c-not-around/rfrw/docs/EM-marine format.png

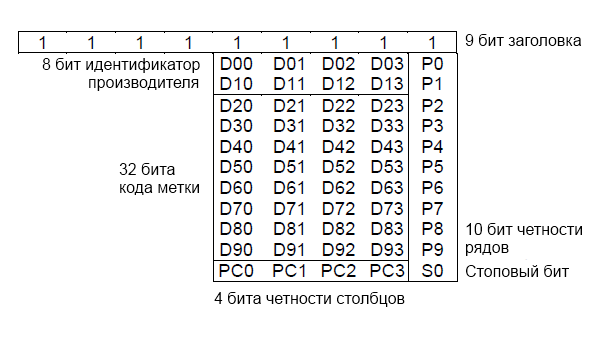
docs/EM-marine format.png
