c-not-around/rfrw/hardware/ATmega328/pcb/module_pcb_dip.png

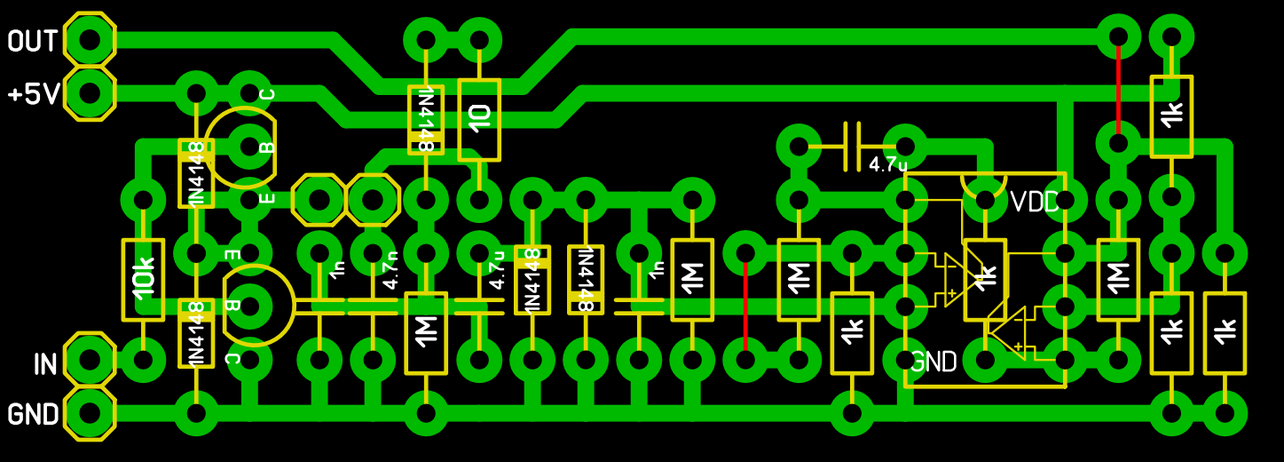
hardware/ATmega328/pcb/module_pcb_dip.png
