c-not-around/rfrw/hardware/ATmega328/pcb/module_pcb_smd.png

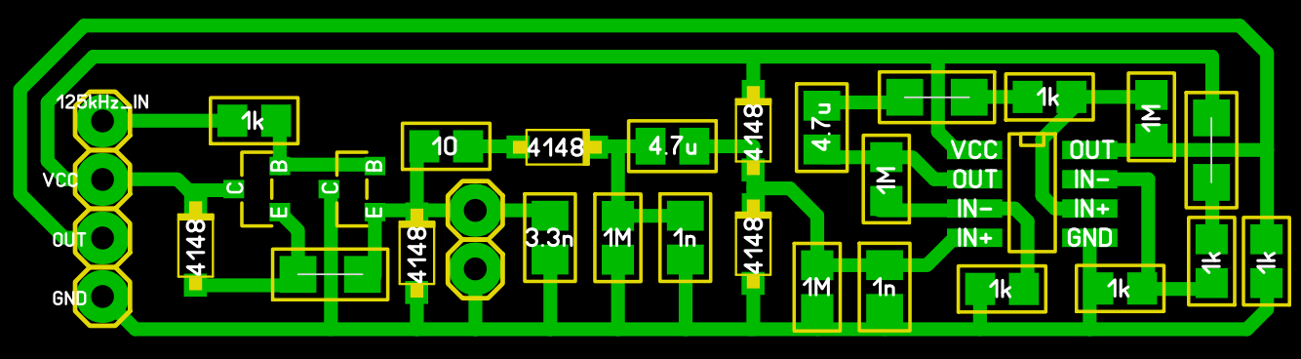
hardware/ATmega328/pcb/module_pcb_smd.png
