c-not-around/rfrw/hardware/ATmega328/schematics/arduino_schematics.png

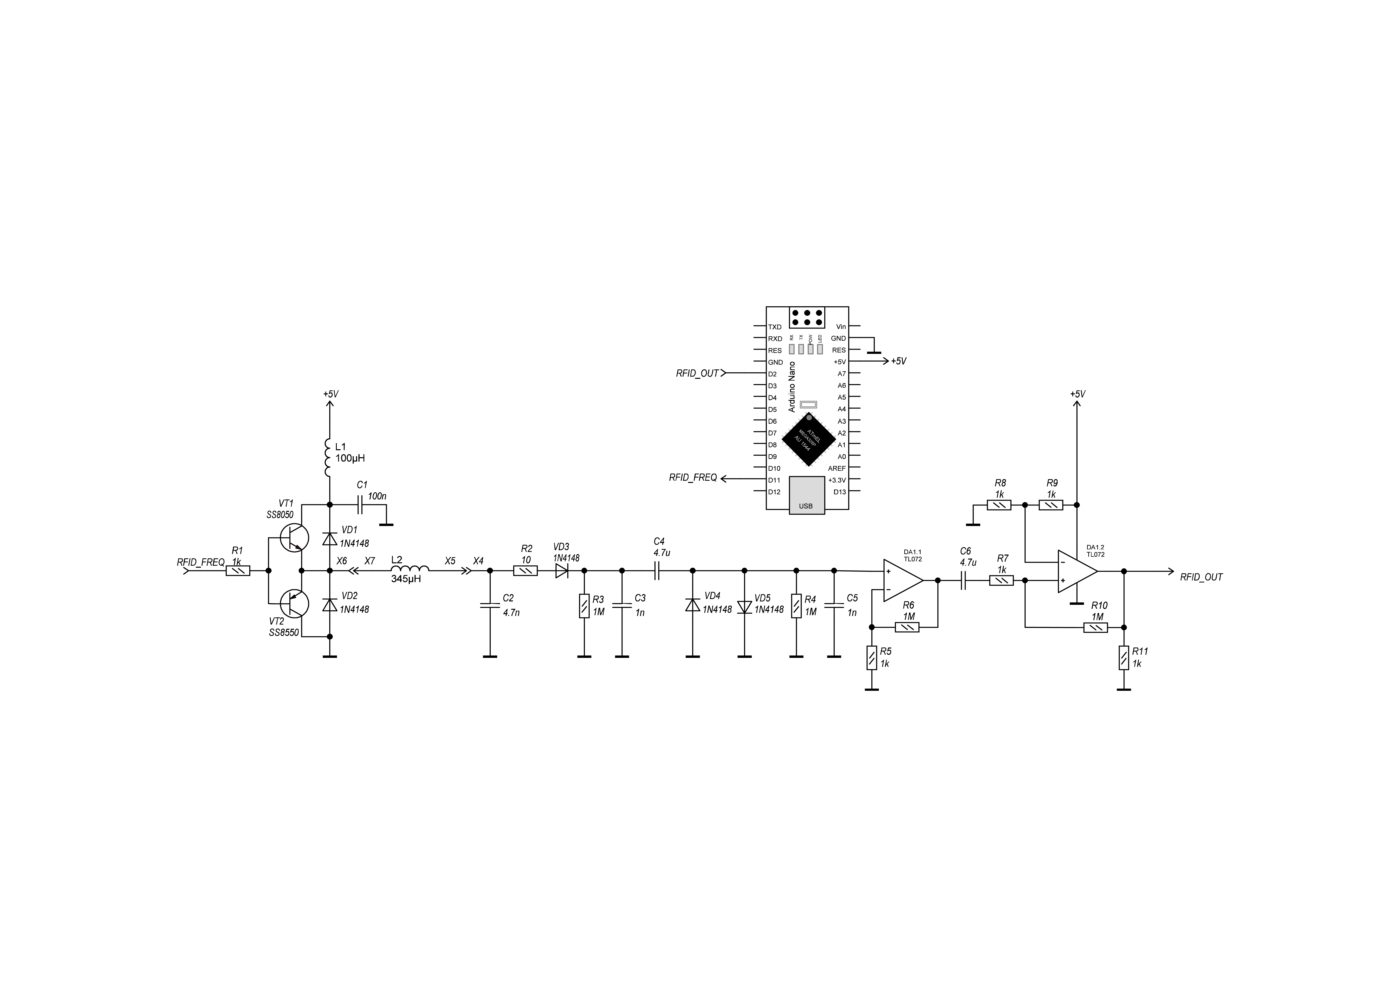
hardware/ATmega328/schematics/arduino_schematics.png
