c-not-around/rfrw/hardware/ATmega328/schematics/atmega328_schematics.png

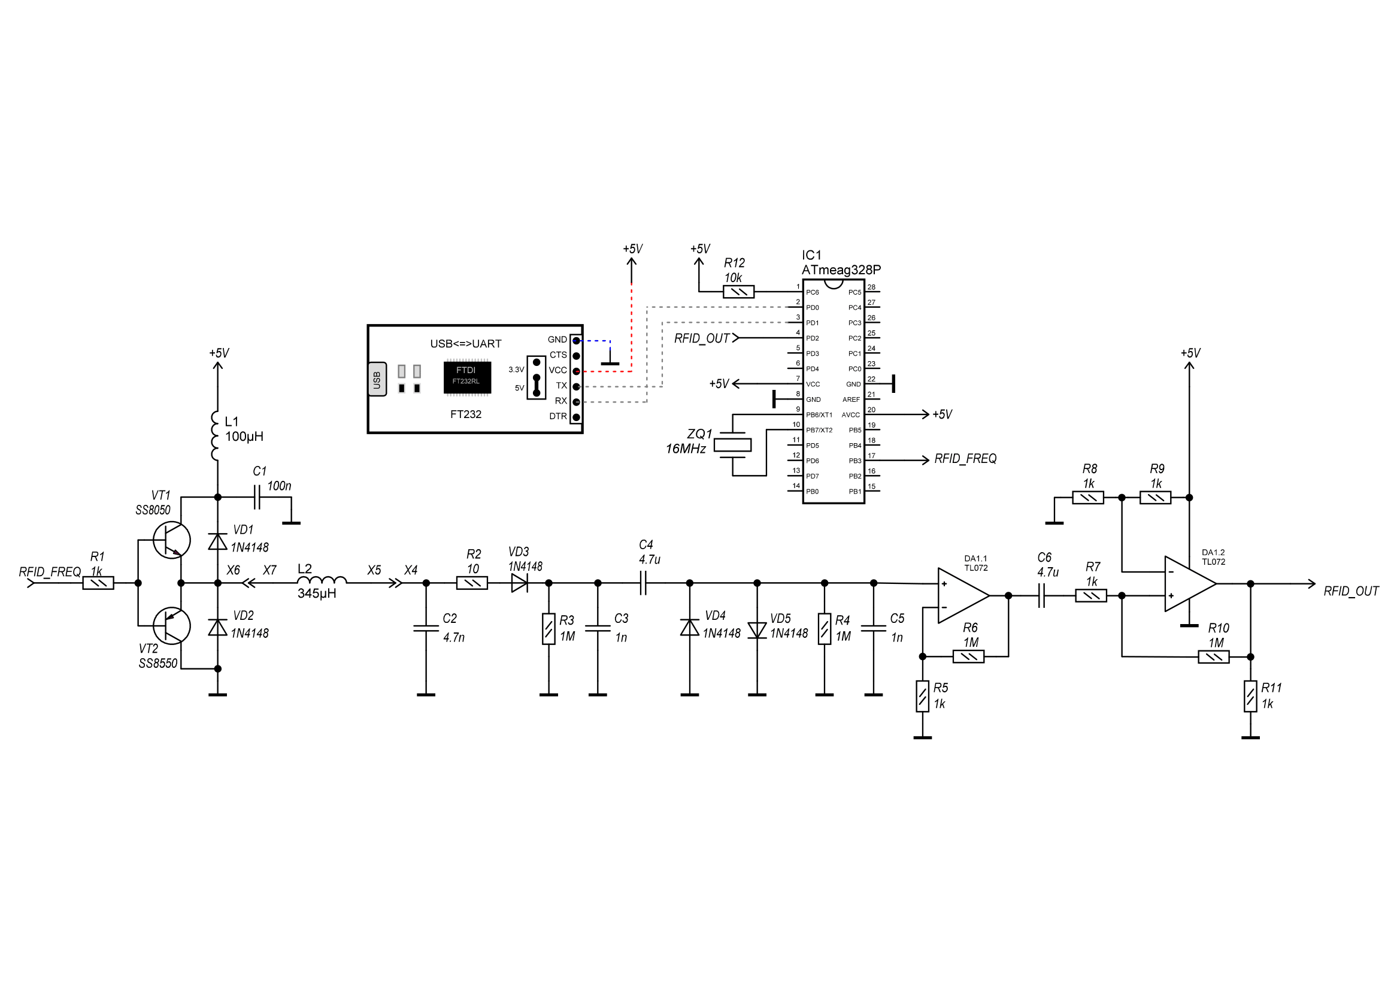
hardware/ATmega328/schematics/atmega328_schematics.png
