c-not-around/rfrw/hardware/PIC12F1840/pcb/default_pcb.png

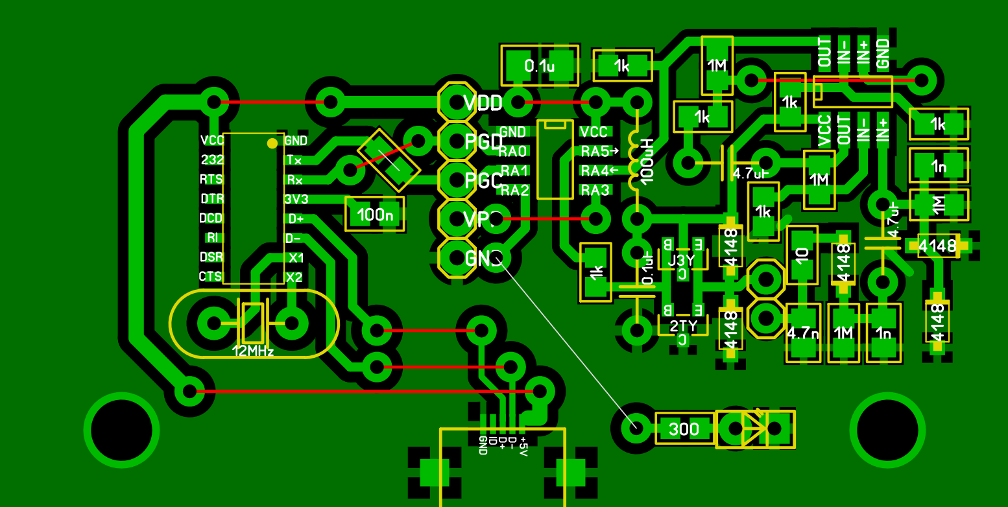
hardware/PIC12F1840/pcb/default_pcb.png
