c-not-around/rfrw/hardware/PIC12F1840/pcb/module_pcb.png

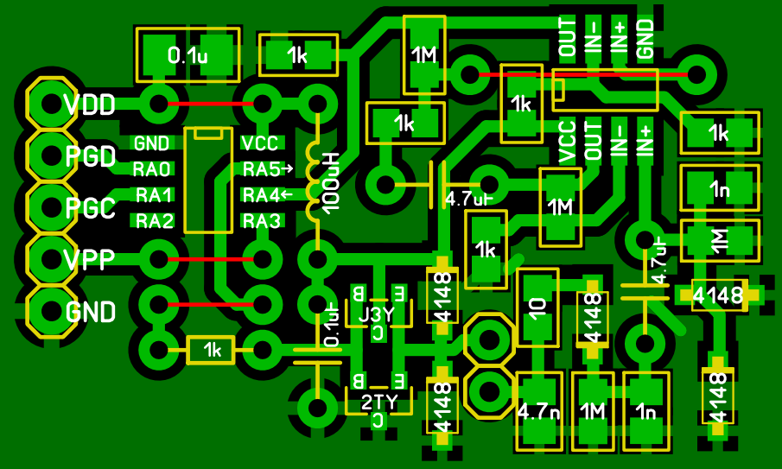
hardware/PIC12F1840/pcb/module_pcb.png
