c-not-around/rfrw/hardware/PIC12F1840/schematics/default_schematics.png

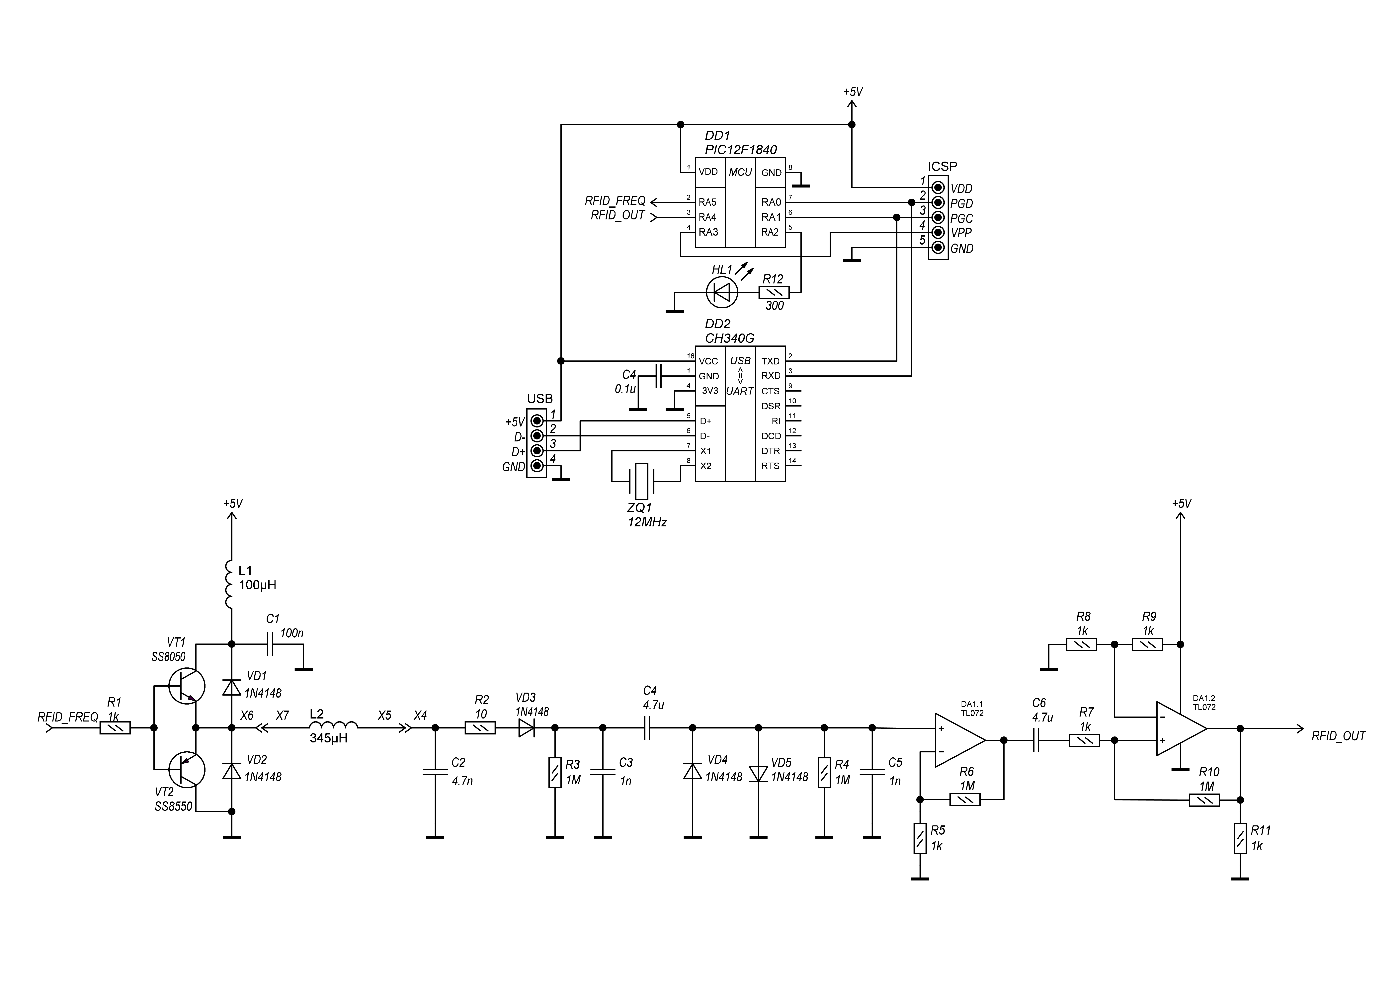
hardware/PIC12F1840/schematics/default_schematics.png
