c-not-around/rfrw/hardware/PIC12F1840/schematics/rdm6300_schematics_initial.jpg

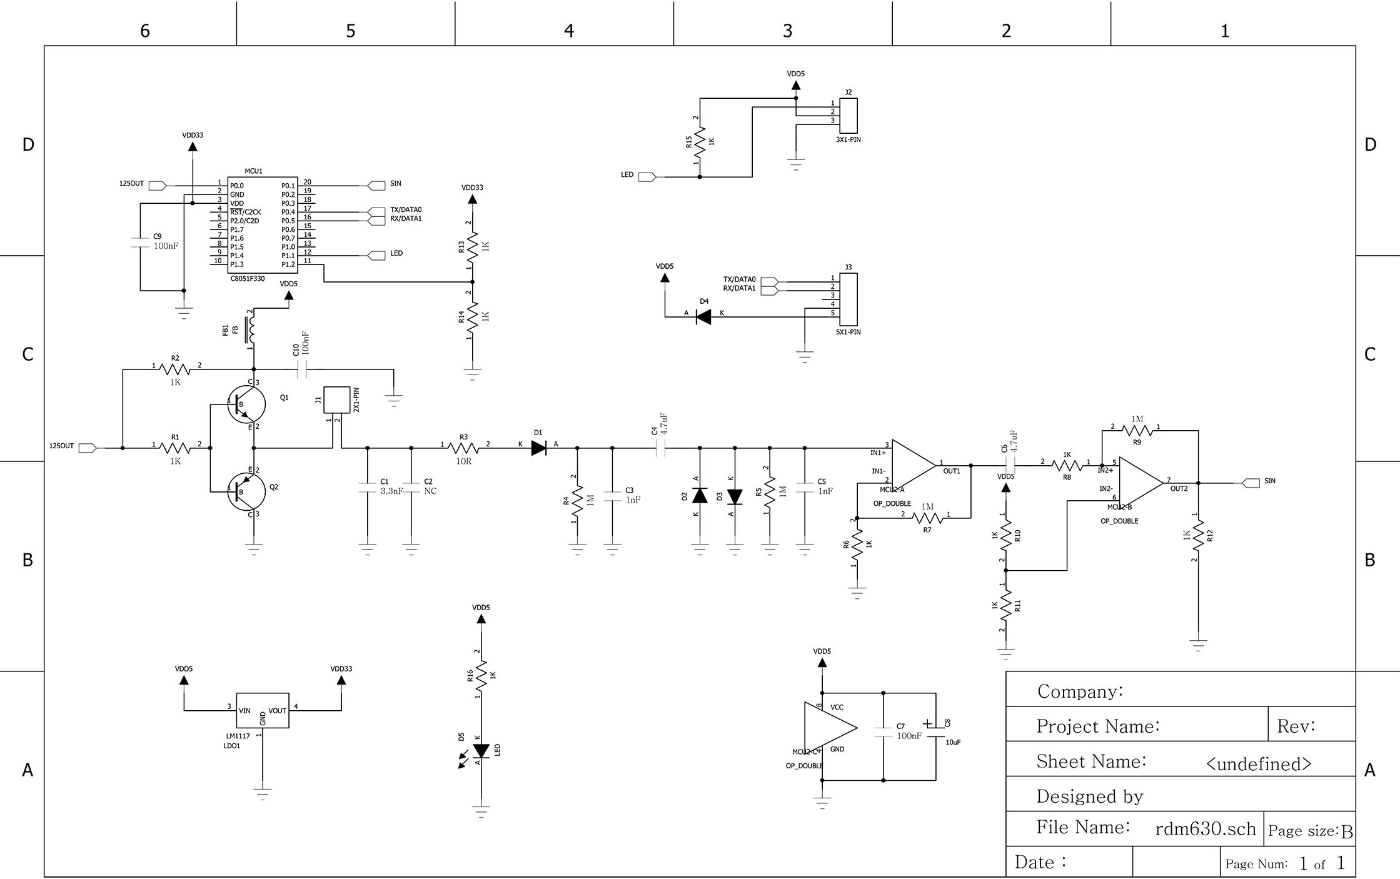
hardware/PIC12F1840/schematics/rdm6300_schematics_initial.jpg
