c-not-around/rfrw/hardware/ATmega328/schematics/arduino_schematics.pdf

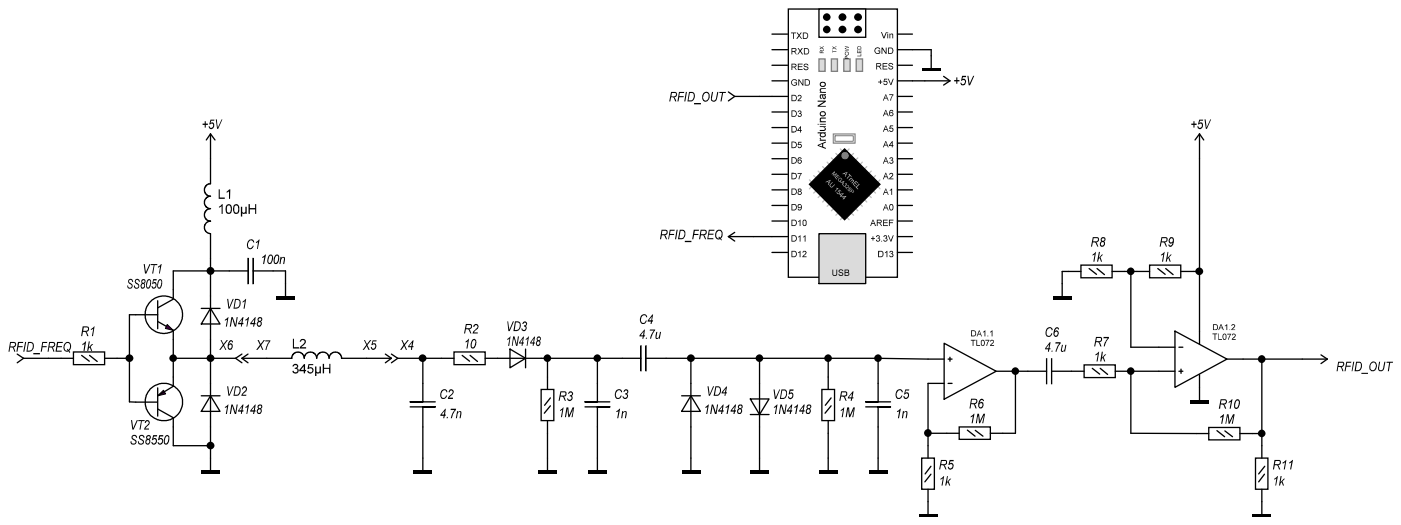
[picture p11: page 1]
