c-not-around/rfrw/hardware/ATmega328/schematics/atmega328_schematics.pdf

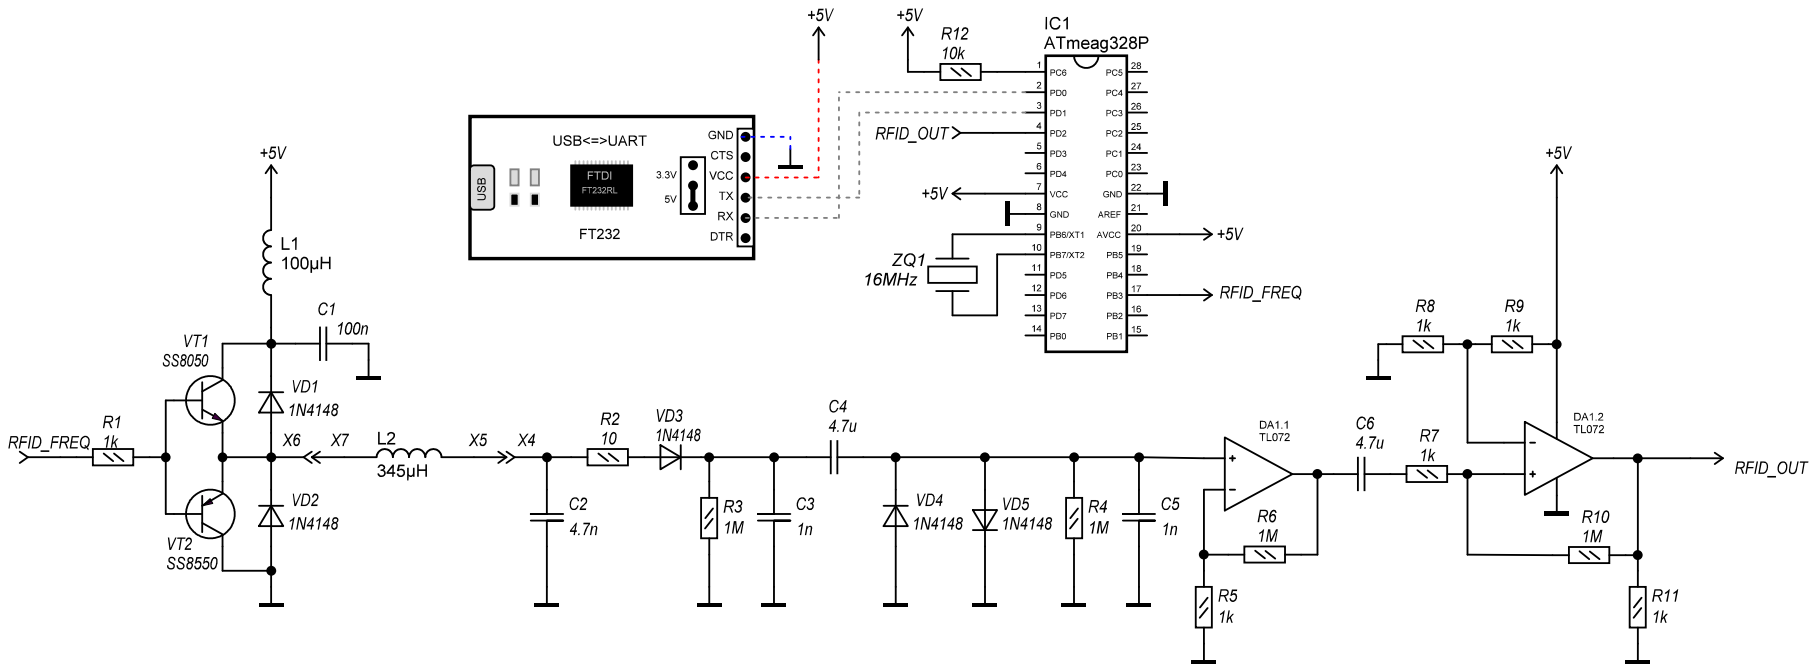
[picture p12: page 1]
