c-not-around/rfrw/hardware/PIC12F1840/schematics/default_schematics.pdf

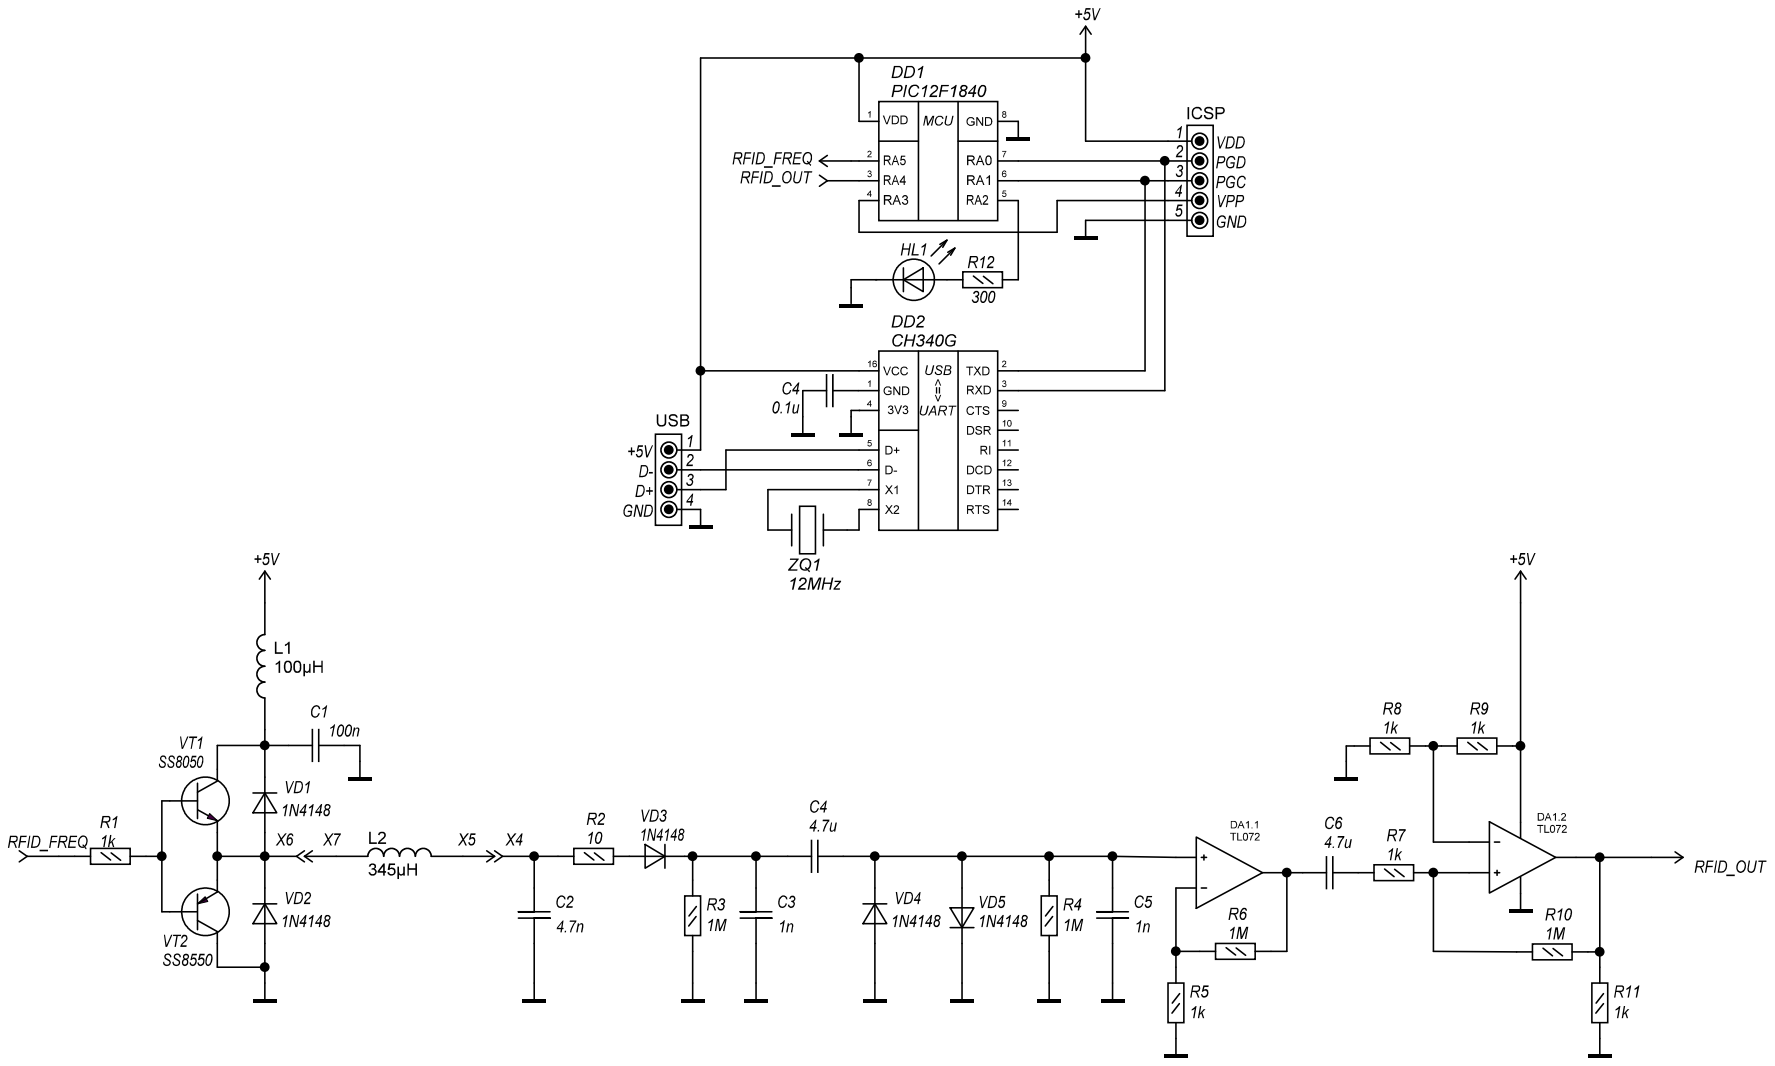
[picture p13: page 1]
