c-not-around/rfrw/hardware/PIC12F1840/schematics/module_schematics.pdf

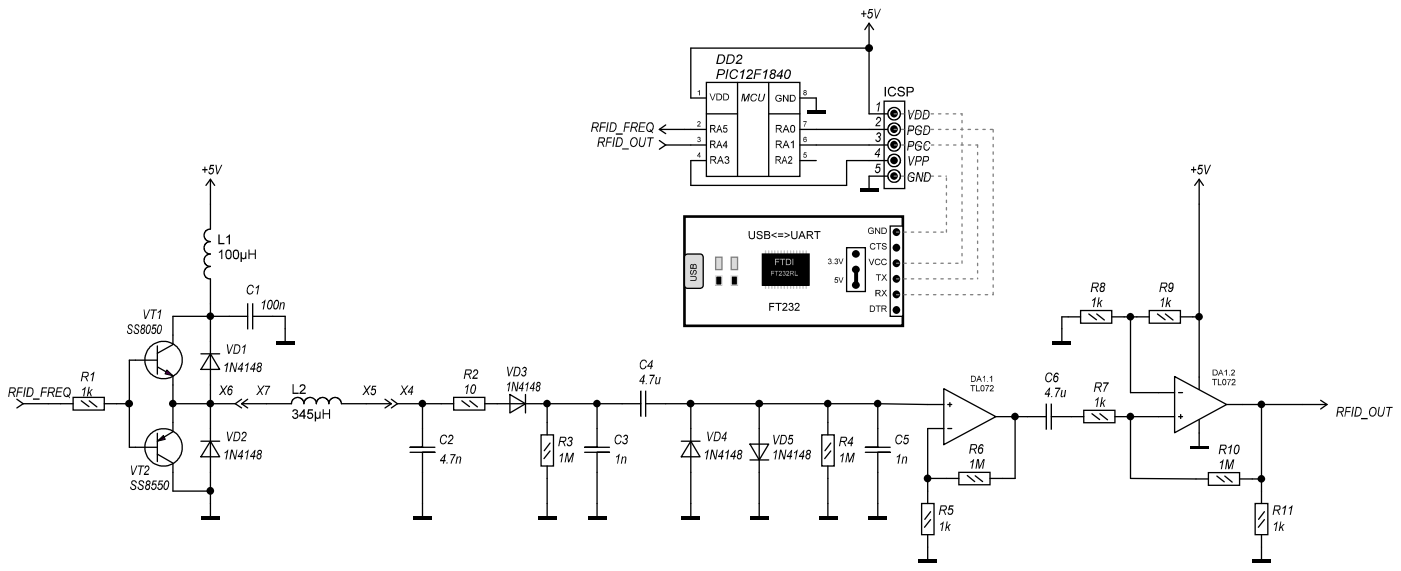
[picture p14: page 1]
