c-not-around/rfrw/hardware/PIC12F1840/schematics/rdm6300_schematics.pdf

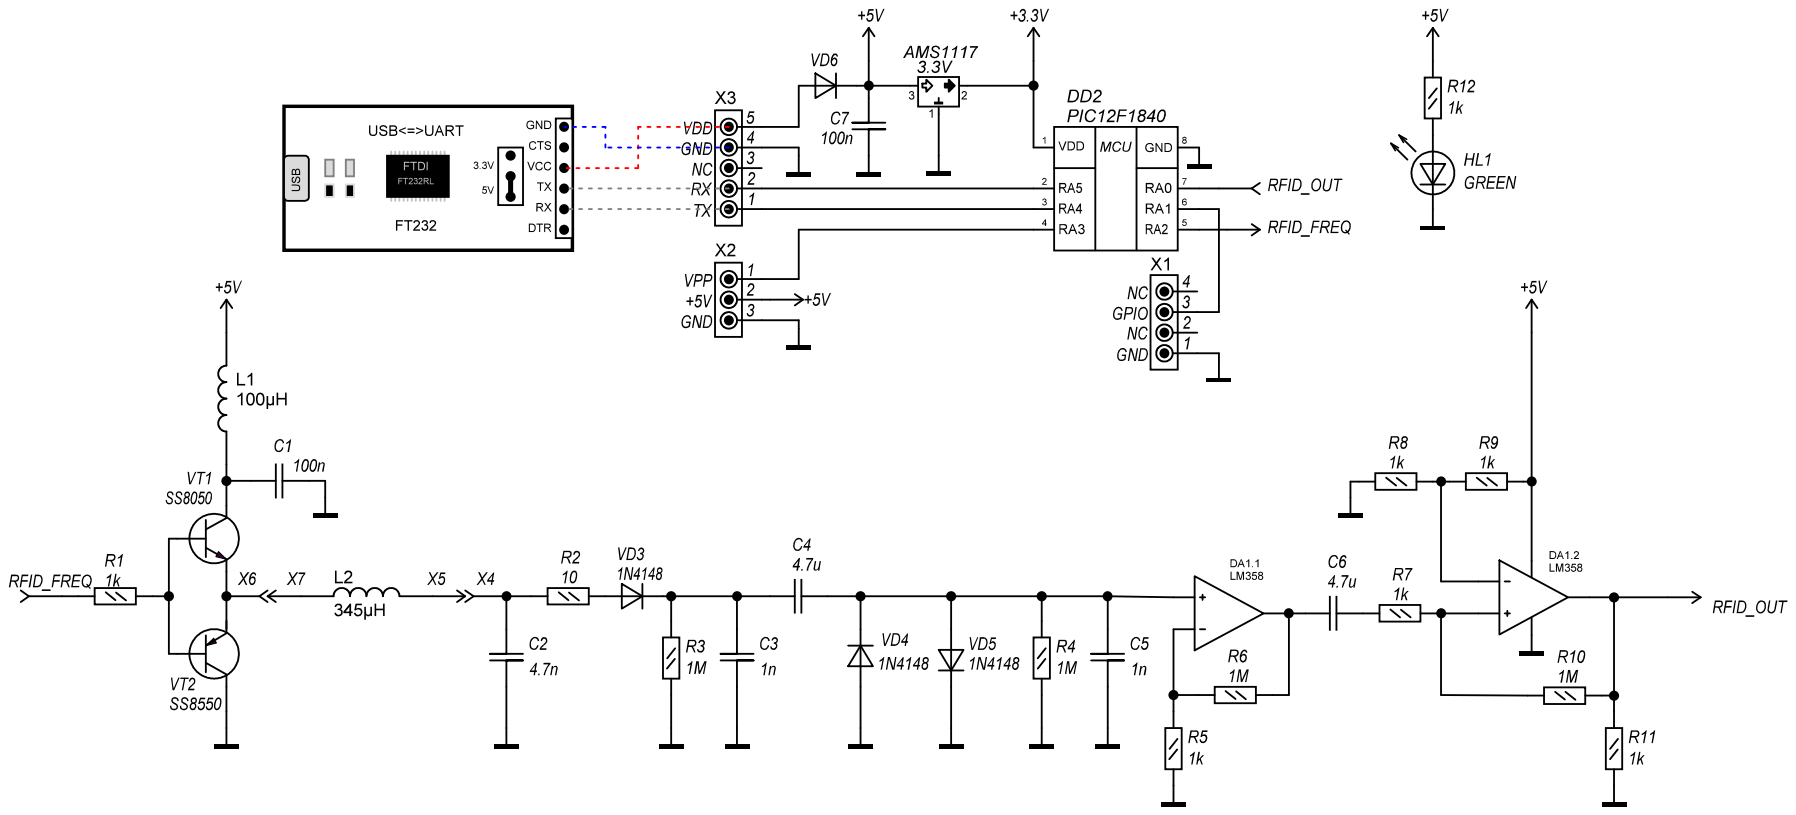
[picture p15: page 1]
