c-not-around/rfrw/(list of files, drawings)

Other design files:
hardware/ATmega328/model_328.pdsprj
hardware/ATmega328/pcb/module_pcb_dip.lay6
hardware/ATmega328/pcb/module_pcb_smd.lay6
hardware/ATmega328/schematics/arduino_schematics.spl8
hardware/ATmega328/schematics/atmega328_schematics.spl8
hardware/PIC12F1840/model_1840.pdsprj
hardware/PIC12F1840/pcb/default_pcb.lay6
hardware/PIC12F1840/pcb/module_pcb.lay6
hardware/PIC12F1840/schematics/default_schematics.spl8
hardware/PIC12F1840/schematics/module_schematics.spl8
hardware/PIC12F1840/schematics/rdm6300_schematics.spl8
