c-not-around/rfrw/hardware/ATmega328/firmware/rfid/rfid_em4x05.h

#ifndef _RFID_EM4X05_H
#define _RFID_EM4X05_H


#include "rfid_defs.h"


//	EM4205, EM4305

#define EM4X05_GAP_LOW1_US			(6*RFID_TC_US)
#define EM4X05_GAP_HIGH1_US			(12*RFID_TC_US)
#define EM4X05_GAP_LOW2_US			(40*RFID_TC_US)
#define EM4X05_GAP_HIGH2_US			(17*RFID_TC_US)

#define EM4X05_BIT_ZERO_LOW_US		(15*RFID_TC_US)
#define EM4X05_BIT_ZERO_HIGH_US		(17*RFID_TC_US)
#define EM4X05_BIT_ONE_HIGH_US		(32*RFID_TC_US)

#define EM4X05_CRC_DISABLE			0x00
#define EM4X05_CRC_ENABLE			0x80

#define EM4X05_COMMAND_BITS			3
#define EM4X05_ADDRESS_BITS			6

#define EM4X05_COMMAND_LOGIN		0x4
#define EM4X05_COMMAND_WRITE_WORD	0x2
#define EM4X05_COMMAND_READ_WORD	0x1
#define EM4X05_COMMAND_PROTECT		0x3
#define EM4X05_COMMAND_DISABLE		0x5

#define EM4X05_BLOCK_ADR_CONFIG		0x4
#define EM4X05_BLOCK_ADR_KEY_L		0x5
#define EM4X05_BLOCK_ADR_KEY_H		0x6

#define EM4X05_BLOCK_BYTES			4
#define EM4X05_BLOCK_WRITE_MS		100
#define EM4X05_WRITE_MS				500

#define EM4X05_CFG_BITRATE_RF8		0x00000003UL
#define EM4X05_CFG_BITRATE_RF16		0x00000007UL
#define EM4X05_CFG_BITRATE_RF32		0x0000000FUL
#define EM4X05_CFG_BITRATE_RF40		0x00000013UL
#define EM4X05_CFG_BITRATE_RF64		0x0000001FUL

#define EM4X05_CFG_CODE_MANCHSTER	0x00000040UL
#define EM4X05_CFG_CODE_BIPHASE		0x00000080UL

#define EM4X05_CFG_DELAY_NO			0x00000000UL
#define EM4X05_CFG_DELAY_BP4		0x00001000UL
#define EM4X05_CFG_DELAY_BP8		0x00002000UL

#define EM4X05_CFG_LAST_WORD_0		0x00000000UL
#define EM4X05_CFG_LAST_WORD_1		0x00004000UL
#define EM4X05_CFG_LAST_WORD_2		0x00008000UL
#define EM4X05_CFG_LAST_WORD_3		0x0000C000UL
#define EM4X05_CFG_LAST_WORD_4		0x00010000UL
#define EM4X05_CFG_LAST_WORD_5		0x00014000UL
#define EM4X05_CFG_LAST_WORD_6		0x00018000UL
#define EM4X05_CFG_LAST_WORD_7		0x0001C000UL
#define EM4X05_CFG_LAST_WORD_8		0x00020000UL
#define EM4X05_CFG_LAST_WORD_9		0x00024000UL
#define EM4X05_CFG_LAST_WORD_10		0x00028000UL
#define EM4X05_CFG_LAST_WORD_11		0x0002C000UL
#define EM4X05_CFG_LAST_WORD_12		0x00030000UL
#define EM4X05_CFG_LAST_WORD_13		0x00034000UL
#define EM4X05_CFG_LAST_WORD_14		0x00038000UL
#define EM4X05_CFG_LAST_WORD_15		0x0003C000UL

#define EM4X05_CFG_LOGIN_DISABLE	0x00000000UL
#define EM4X05_CFG_LOGIN_READ		0x00040000UL
#define EM4X05_CFG_LOGIN_WRITE		0x00100000UL
#define EM4X05_CFG_LOGIN_READWRITE	0x00140000UL

#define EM4X05_CFG_DISABLE_OFF		0x00000000UL
#define EM4X05_CFG_DISABLE_ON		0x00800000UL

#define EM4X05_CFG_RTF_DISABLE		0x00000000UL
#define EM4X05_CFG_RTF_ENABLE		0x01000000UL

#define EM4X05_CFG_PIGEON_DISABLE	0x00000000UL
#define EM4X05_CFG_PIGEON_ENABLE	0x04000000UL

#define EM4X05_CONFIG_KEY_WRITE		(EM4X05_CFG_BITRATE_RF64 | EM4X05_CFG_CODE_MANCHSTER | EM4X05_CFG_LAST_WORD_6)


#endif
