c-not-around/rfrw/hardware/ATmega328/firmware/rfid/rfid_t55x7.h

#ifndef _RFID_T55X7_H
#define _RFID_T55X7_H


#include "rfid_defs.h"


//	T5557, T5577, T5567, E5550, E5551

#define T55X7_START_GAP_US			(30*RFID_TC_US)

#define T55X7_BIT_GAP_US			(14*RFID_TC_US)
#define T55X7_BIT_ZERO_US			(24*RFID_TC_US)
#define T55X7_BIT_ONE_US			(56*RFID_TC_US)

#define T55X7_BLOCK_BITS			33
#define T55X7_OPCODE_BITS			2
#define T55X7_LATCH_BITS			1
#define T55X7_BLOCK_ADR_BITS		3

#define T55X7_BLOCK_BYTES			((T55X7_BLOCK_BITS-T55X7_LATCH_BITS)/8)

#define T55X7_OPCODE_RESET			0x0
#define T55X7_OPCODE_WRITE			0x2
#define T55X7_LATCH_UNLOCK			0x0
#define T55X7_LATCH_LOCK			0x1

#define T55X7_BLOCK_ADR_CONFIG		0x0
#define T55X7_BLOCK_ADR_KEY_H		0x1
#define T55X7_BLOCK_ADR_KEY_L		0x2

#define T55X7_WRITE_MS				500
#define T55X7_BLOCK_WRITE_MS		100

#define T55X7_CFG_SAFERKEY_OFF		0x00000000UL
#define T55X7_CFG_SAFERKEY_ON		0x60000000UL

#define T55X7_CFG_BITRATE_RF8		0x00000000UL
#define T55X7_CFG_BITRATE_RF16		0x00040000UL
#define T55X7_CFG_BITRATE_RF32		0x00080000UL
#define T55X7_CFG_BITRATE_RF40		0x000C0000UL
#define T55X7_CFG_BITRATE_RF50		0x00100000UL
#define T55X7_CFG_BITRATE_RF64		0x00140000UL
#define T55X7_CFG_BITRATE_RF100		0x00180000UL
#define T55X7_CFG_BITRATE_RF128		0x001C0000UL

#define T55X7_CFG_MOD_DIRECT		0x00000000UL
#define T55X7_CFG_MOD_PSK1			0x00001000UL
#define T55X7_CFG_MOD_PSK2			0x00002000UL
#define T55X7_CFG_MOD_PSK3			0x00003000UL
#define T55X7_CFG_MOD_FSK1			0x00004000UL
#define T55X7_CFG_MOD_FSK2			0x00005000UL
#define T55X7_CFG_MOD_FSK1A			0x00006000UL
#define T55X7_CFG_MOD_FSK2A			0x00007000UL
#define T55X7_CFG_MOD_MANCHESTER	0x00008000UL
#define T55X7_CFG_MOD_BIPHASE50		0x00010000UL

#define T55X7_CFG_PSKCF_RF2			0x00000000UL
#define T55X7_CFG_PSKCF_RF4			0x00000400UL
#define T55X7_CFG_PSKCF_RF8			0x00000800UL

#define T55X7_CFG_AOR_OFF			0x00000000UL
#define T55X7_CFG_AOR_ON			0x00000200UL

#define T55X7_CFG_MAX_BLOCK_0		0x00000000UL
#define T55X7_CFG_MAX_BLOCK_1		0x00000020UL
#define T55X7_CFG_MAX_BLOCK_2		0x00000040UL
#define T55X7_CFG_MAX_BLOCK_3		0x00000060UL
#define T55X7_CFG_MAX_BLOCK_4		0x00000080UL
#define T55X7_CFG_MAX_BLOCK_5		0x000000A0UL
#define T55X7_CFG_MAX_BLOCK_6		0x000000C0UL
#define T55X7_CFG_MAX_BLOCK_7		0x000000E0UL

#define T55X7_CFG_PASSWORD_OFF		0x00000000UL
#define T55X7_CFG_PASSWORD_ON		0x00000010UL

#define T55X7_CFG_SEQ_TERM_OFF		0x00000000UL
#define T55X7_CFG_SEQ_TERM_ON		0x00000008UL

#define T55X7_CFG_POR_DELAY_OFF		0x00000000UL
#define T55X7_CFG_POR_DELAY_ON		0x00000001UL

#define T55X7_CONFIG_KEY_WRITE		(T55X7_CFG_BITRATE_RF64 | T55X7_CFG_MOD_MANCHESTER | T55X7_CFG_MAX_BLOCK_2)


#endif
